DevAnyKR/CreMaker_TuneUp/README.md

# CreMaker_TuneUp

크리메이커 3D 프린터 메탈 V2에 관련된 튜닝 자료 공유 및 관리를 위한 공간입니다.

3D 모델은 '[3D_Models](/3D_Models)'에 분류별로 디렉토리가 구성되어 있습니다.

자세한 내용은 Wiki를 참고해주세요.
[Wiki 튜닝된 항목](../../wiki/튜닝된-항목)

***

### DevAny® 소개

자동화 기계를 제조, 납품, 기술 지원을 한 경험이 많으며, 정밀 기계 설계, 제작에 관심이 많은 기술 전문가입니다.

3D 출력용 PLA 재질로는 1/100mm 만큼의 기계 가공 공차를 따라갈 수는 없지만, 그에 걸맞는 기본 기계 원리만 적용하여도 최대한 교정을 할 수 있습니다. 튜닝 후, 실제 출력물 또한 상당히 매끄럽게 출력됩니다.

고급 부품을 사용하여 튜닝하면 더더욱 좋겠지만, DIY 프린터를 선택한 이유처럼 최대한 저렴한 비용으로 누구나 튜닝할 수 있도록 기술 자료를 등록합니다.

***

## 튜닝 미리보기

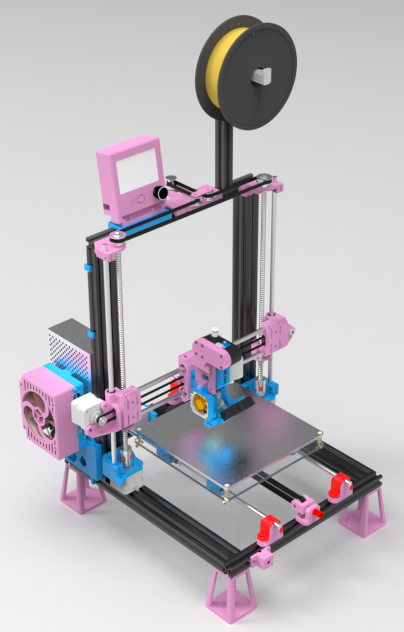
[picture p1: 3D_Models/CMV2_Tuned.png]


***

## Wiki

https://github.com/DevelopmentAnything/CreMaker_TuneUp/wiki

(정리된 문서입니다.)

## 토론
https://github.com/DevelopmentAnything/CreMaker_TuneUp/discussions

(의견, 질문을 할 수 있어요.)

## 보고
https://github.com/DevelopmentAnything/CreMaker_TuneUp/issues

(문제점, 버그 리포트를 해주세요.)

***

# License
파일별로 라이선스는 조금씩 다릅니다.
예) Cremaker의 파일, DevAny®의 파일

복잡할 것 없이, 자유롭게 사용하고, 개선된 내용은 피드백을 해주시면 됩니다.
(협업 목적)

복제 배포시 최초 원본 파일의 링크와 함께 배포를 권장합니다. (혼란 방지 및 피드백 목적)

코드를 변경 후 배포시 원본 파일 또는 원본 파일의 링크와 함께 수정된 파일의 코드도 배포해야 합니다.
예) STEP 파일을 변경하고 STL 파일로 변환된 파일을 배포 시, 변경된 STEP 파일도 함께 배포해야 합니다. (배포 받은 사용자도 원본을 수정할 권한이 있음)
