DevAnyKR/CreMaker_TuneUp/3D_Models/Addons/Acrylic_Reinforcement_Block/readme.md

# Acrylic_Reinforcement_Block



## 파일 설명

아크릴 휨 방지 강화 블록입니다.

## 출력 조건

- ~180mm_B1.stl 모델은 2개씩 1세트 출력. (측면 강화시 2세트 추가 출력)
  - 단, 손잡이 사용시 블록 1개를 ~180mm_B2.stl 모델로 대체합니다.
- ~100mm_B1.stl 모델은 2개씩 1세트 출력
- 구멍은 축소하면 뻑뻑해짐. 0.05~0.1 정도 확장 추천
- 넓은 면이 바닥으로 오도록 회전
- 재질: eSUN PLA+, PETG 이상의 강도를 가진 필라멘트 필수(절대 다락방 Fine PLA 사용 금지). 출력물이 휘면 안 됨.
- 내외벽 두께: 1.2mm 이상, 내부채움 지그재그 기준 50% 이상.



## 준비물

- M3\*20 볼트 및 너트 18개

***

# Bed Handle

## 파일 설명

아크릴 휨 방지 고정 블록에 사용하는 손잡이 입니다.



## 준비물

- M3\*12~15 볼트 및 너트 2개

## Update
-
