DevAnyKR/CreMaker_TuneUp/3D_Models/Addons/Gyro-Adapter/readme.md

# Gyro-Adapter

+ 자이로 스피너용 어댑터입니다.
+ 장식물입니다.

# 준비물

+ [Gyro Model](https://www.thingiverse.com/thing:2839576)
