DevAnyKR/CreMaker_TuneUp/3D_Models/Addons/Filament_Support/Bearing/ReadMe.md

# Bearing for Filament bobin

필라멘트 공급을 원활하게 하여 익스트루더 모터 부하를 줄이고 출력 품질을 일정하게 유지시킵니다.

## 미리 보기



## 출력 조건
- 눕혀서 출력
- 서포트 OFF

## 사용

1. 설명: 필라멘트 거치대에 끼워서 사용합니다.

2. 출력 개수: 4개 권장

※ 필라멘트 롤이 이탈되는 것을 방지하기 위해 아래 클립을 출력하여 끼워 줍니다.

https://github.com/simulz/CreMaker_TuneUp/tree/main/3D_Models/Addons/Filament_Support/Clip/STL
