DevAnyKR/CreMaker_TuneUp/3D_Models/Addons/Filament_Support/Clip/readme.md

# Clip for Bearing

필라멘트 보빈용 베어링 사용 시, 필라멘트 롤이 이탈되는 것을 방지하는 클립입니다.

## 사용 예





필라멘트를 거치하거나 제거할 때, 롤을 들어 올리면 되므로 사용하는데 불편이 없습니다.
