DevAnyKR/CreMaker_TuneUp/3D_Models/readme.md

# 디렉터리 구분
## Main Parts
프린터 주요 부품입니다.

## Addons
추가 액세서리입니다.

***

아래 그림 처럼 튜닝할 수 있습니다.



***

# Ultimaker Cura

오픈소스 무료 슬라이서

https://github.com/Ultimaker/Cura
