DevAnyKR/CreMaker_TuneUp/3D_Models/Addons/BTT_Smartsensor_Mount/readme.md

# BTT_Smartsensor_Mount



## 파일 설명

필라멘트 감지 센서용 마운트입니다.

### 효과

펄스 방식 센서는 필라멘트를 다 썼거나, 필라멘트가 내부에서 끊어졌거나, 노즐이 막혔거나, 기어가 헛돌거나, 필라멘트가 갈렸을 때 감지하여 출력을 일시정지합니다.

(On/Off 방식은 필라멘트가 없을 때만 감지하지만, BTT 센서는 흐름을 감지하여 위 상황을 모두 감지합니다.)

## 미리보기



## 출력 조건
- 서포트가 필요 없는 면이 바닥으로 오도록 회전

## 준비물

- M3\*40 볼트 및 너트 1개
- BTT Smart Filament Sensor
  - 구매링크: [AliExpress BigTreeTech 공식 스토어](https://s.click.aliexpress.com/e/_DeteAfP)



## 설치 및 사용





디스플레이 보드에 있는 커넥터에 꽂으면 됩니다.

터치 패널로 기기 설정으로 들어간 다음, 필라멘트 센서를 Auto로 설정하면 됩니다.



필라멘트를 삽입할 때 익스트루더 블록 구멍에 잘 들어가지 않으면, 센서 마운트 블록을 꺾어서 삽입하면 됩니다.

## Update
-
