DevAnyKR/CreMaker_TuneUp/3D_Models/Addons/Foot_Lift/readme.md

# Foot Lift

- 프린터를 올려주는 받침대 입니다.
- 바닥 공간이 생기므로 청소하기가 편합니다.

## 미리 보기



## 사용 예



## 출력 조건

+ 내부채움: 100%
+ 재질: eSun PLA+ 이상의 강도를 가진 필라멘트 권장
