DevAnyKR/CreMaker_TuneUp/3D_Models/Addons/Profile-Home-Cover/readme.md

# Profile-Home-Cover

프로파일의 홈을 덮는 커버입니다.

## 사용 예
