DevAnyKR/CreMaker_TuneUp/3D_Models/Addons/Tool_Holder/readme.md

# Tool-Holder

서포트가 필요 없는 공구 거치대입니다.

## 사용 예
