DevAnyKR/CreMaker_TuneUp/3D_Models/Addons/Z-Align-Indicator/readme.md

# Z-Align-Indicator

Z축의 원점이 정상적으로 원위치 됐는지 확인하는 표시기입니다.

## 사용 예



## 출력 조건

스크류에 꽂는 부품은 출력 설정에 따라 헛도는 경우가 있으니, 고정이 잘 되지 않으면 내경을 줄여서 출력해보세요.
