DevAnyKR/CreMaker_TuneUp/3D_Models/Main_Parts/Y/Y-bearing-block/readme.md

# Y-bearing-block

+ Y 벨트 장력 조절 블록입니다.



## 효과

### before

- 장력 조정용 측면 볼트를 조이면, 블록 조정용 볼트의 나사산이 뭉개짐
- 장력 조정을 하려면 볼트 4개를 모두 풀고 다시 조여야 함
- 장력 조정용 측면 볼트를 강하게 조이면, 너트 고정 부분이 파손됨

### after

- 볼트의 나사산이 뭉개지지 않음
- 주 블록은 알루미늄 프로파일에 한 번만 고정하면 되며, 장력 조정은 측면 볼트 1개만 풀고 조이면 됨
- 측면 솔리드는 보강대로 강하게 붙어있으므로 장력 조정 볼트를 강하게 조여도 파손 위험이 적음 

## 미리 보기

img (3)
img (4)

## 사용 예



## 파일 설명

+ 3.2L: 기본 모델(추천)
+ 3.3L: 측면 홈따기 모델(벨트가 기계의 중심이 아닐 때, 좌우 위치 조정용)

## 준비물

+ M6\*20~30mm 볼트
  + 볼트가 길 경우, washer 모델을 출력해서 사용하거나, 금형 스프링(내경 6mm)을 사용할 수 있습니다.

## 출력 조건

+ eSUN PLA+ 추천. 또는 PETG, ABS 등 강도가 높은 재질
+ 내외벽 1.2mm 이상, 내부채움 50% 이상
+ 측면이 베드 바닥으로 향하도록 배치 (조립 방향으로 배치하면 층이 분리될 수 있음)
