DevAnyKR/CreMaker_TuneUp/3D_Models/Main_Parts/Bed/Bed-belt-block/readme.md

# Bed-belt-block
+ Y 벨트를 고정하는 블록입니다.
+ 2차 저작물입니다, 원본: https://cafe.naver.com/cremaker/16533

## 효과

### Before

+ 진동 발생 및 블록이 헐거워지면 벨트가 빠짐

### After

+ 볼트로 압착하므로 벨트가 빠지지 않음

## 미리 보기





## 출력 조건

+ 재질: PLA 외.
+ 내외벽 두께는 0.8mm 이상, 내부채움은 지그재그 기준 20% 이상.
