DevAnyKR/CreMaker_TuneUp/3D_Models/Main_Parts/X/Self-Aligning-Module/readme.md

# Self-Aligning-Module

- Z축 상하 이동시, 리드스크류 진동을 흡수합니다.
- 자석을 사용함으로써 볼의 위아래 홈을 정렬하여 볼이 움직일 수 있도록 공간을 확보합니다.
- X축 어셈블리는 중력에 의해 얹혀있는 형태입니다.

selfaligningmodule

모듈 아래쪽 리드 스크류 블록만 떠는 것이 보이쥬?

## 효과

### before
- 스크류가 진동하는 것에 맞춰 X축 어셈블리가 XY 방향으로 진동함. 결국 Side wall의 Skin이 물결처럼 울퉁불퉁하게 출력 됩니다.
- 휘어진 스크류의 횡력이 베어링봉에 영향을 줍니다.

### After
- 꿀결~
- 자기정렬 모듈의 하부만 스크류에 맞춰 진동을 하며, 상부와 나머지 기계 부품에는 힘을 전달하지 않습니다.
- X축 어셈블리는 볼트 고정이 아니므로 손으로 들어올릴 수 있습니다.
- Z축이 하강 중, 한계를 넘어가거나 출력물에 부딪힐 경우 X축 어셈블리 전체가 들리므로 기계적인 손상을 줄입니다.
- (옵션)각 모듈마다 롱볼트 2개를 추가하여, X축 어셈블리가 분리되는 것을 강제할 수 있습니다(비추).

## 사용예




## 출력 조건

- *Magnet_Bottom Plate.stl*, *Magnet_Top Plate.stl* 모델은 1개씩 2세트 출력
- 서포트 필요 없는 방향으로 회전
- 개조된 *X-block-Cut* 모델을 사용해야 함.

### X-block 변경 사항

+ 상하 반전
+ self-aligning module 장착 홀
+ X축 베어링봉 고정 클립 반전
+ X축 베어링봉 길이 확장 가능
+ 모듈 간섭 부분 솔리드 잘라내기

## 추가 자재
+ 1세트: 6mm BB탄 4개, 상하 2극 분할 착자된 Ø8\*4mm 원형 자석 4개, M3\*8 2개, M3\*10 2개

  ※ 상하 2극 분할 자석이 아닌 수평 2극 분할 자석인 경우, 먼저 한 쪽의 자석을 본딩하고, 맞붙는 쪽의 자석은 가조립 상태에서 방향을 맞춘 후 본딩해야 합니다.(반발력으로 인한 오동작 방지)

## 조립



- 자석은 *록타이트 401* 접착제(혐기성 본드)로 고정합니다.

## Update
-
