DevAnyKR/CreMaker_TuneUp/3D_Models/Main_Parts/Y/Y-rod-support-Cover/ReadMe.md

# Y-rod-support-Cover

+ 심각한 설계 결함인 베어링봉 고정부를 개선한 모델입니다.

## 효과

### Before

+ 케이블 타이로는 베어링봉을 단단히 고정할 수 없음(디지털 조임 방식이므로)
+ 베드에 하중이 걸리면 베어링봉이 휘어짐. 이동 부하 발생 및 출력물 높이 변형 문제 발생

### After

+ 강력한 힘으로 베어링봉을 고정할 수 있음
+ 베드에 하중이 걸려도 베어링봉을 수평 상태로 유지함
+ 미관이 좋아짐

## 파일 설명
- Y-rod-support-Cover_A.stl

*단순 돔 모양의 기본형 (순정 블록용)*

- Y-rod-support-Cover_B.stl

*LM8LUU용 간섭 제거 (롱타입 부싱 블록용)*

# 출력 조건



+ 그림과 같이 볼트 구멍 방향을 참고하여 모델을 눕혀서 배치.
+ 힘이 작용하므로 eSun PLA+, PETG 같은 고강도 재질 필수(다락방 PLA Fine 절대 비추).
+ 효과를 극대화 하려면 관통형 모델을 사용하고, Y축 베어링봉을 최소 410mm 이상으로 교체할 것.

***
## Update
1.2, 2.2: 바닥 안쪽 모따기 치수 변경 0.5→1.0
