DevAnyKR/CreMaker_TuneUp/3D_Models/Main_Parts/Z/BearingUnit-Bottom/readme.md

# BearingUnit-Bottom

- 리드 스크류를 베어링으로 동심을 잡아주는 블록입니다.

# 안내

- 이 모델은 폐기되었습니다.
- [Screw-Coupler](https://github.com/simulz/CreMaker_TuneUp/tree/main/3D_Models/Main_Parts/Z/Screw-Coupler) 와 [Self-Aligning-Module](https://github.com/simulz/CreMaker_TuneUp/tree/main/3D_Models/Main_Parts/X/Self-Aligning-Module)을 사용하세요.
