DevAnyKR/CreMaker_TuneUp/3D_Models/Main_Parts/Z/Screw-Coupler/readme.md

# Screw-Coupler

- 이 튜닝은 출력물이 아닌 기성품을 교체하는 것입니다.

## 효과

### before

- 스크류의 나사산이 뭉개짐
- 커플러가 압축·인장 되면서 높이가 변하여 X축의 수평이 틀어짐
- 커플러와 스크류의 동심이 맞지 않아 회전시 XY 방향으로 진동 발생
- 커플러의 내경이 커서 스크류를 수직으로 고정할 수 없음

### after
- 스크류의 나사산 전체를 감싸는 방식으로 뭉개짐이 거의 없음
- 우레탄을 사용하여 커플러의 높이가 변하지 않음
- 스크류를 감싸는 방식으로 고정되므로 동심이 거의 맞음
- 커플러가 휘지 않으므로 스크류를 수직으로 고정할 수 있음

## 사용예



## 준비물



- 지름 20mm, 길이 25mm, 내경은 위아래가 각각 5mm, 8mm의 커플러 2개

AliExpress:

https://s.click.aliexpress.com/e/_De5ohud

https://s.click.aliexpress.com/e/_DEQ3OeH

***
## Update

-
