DevAnyKR/CreMaker_TuneUp/3D_Models/Main_Parts/Power_Board/Board-Case-Cover_92mm-Fan/readme.md

# Board Case Cover for 92m Fan

메인보드 여닫이 커버입니다.

로고를 넣었지만 점은 없는 짝퉁 로고... 시원하게 뚫어버렸습니다.

원본: https://cafe.naver.com/cremaker/16533

## 미리보기

img1 daumcdn

## 사용예




## 추천


온도 스위치를 연결하여 모터 드라이버가 뜨거워질 때만 팬이 회전하도록 하는 방법으로, 뜨거워지는 상태를 알 수 있으며, 불필요한 동작을 방지할 수 있습니다.

## 준비물

팬: NOCTUA NF-A9x14 PWM 

DCDC컨버터: SZH-PWSD-014

## 추가 준비물

온도 스위치: PT-01 50~70℃

써멀 패드: 15W/mk 권장

## 출력 조건

재질: 상관 없음

방향: 넓은 면이 바닥으로 오도록 배치
