DevAnyKR/CreMaker_TuneUp/3D_Models/Main_Parts/Z/BearingUnit-Top/readme.md

# BearingUnit-Top

- 리드 스크류를 베어링 유닛으로 동심을 잡아주는 블록입니다.
- [Self-Aligning-Module](https://github.com/simulz/CreMaker_TuneUp/tree/main/3D_Models/Main_Parts/X/Self-Aligning-Module)을 적용했다면 베어링 유닛을 장착할 필요가 없습니다.

## 미리보기



## 출력하기

+ 원본 모델 1개, 반전된 모델 1개

+ 윗면을 베드면에 붙여서 서포트가 필요 없도록 배치

## 준비물

+ KFL08 베어링 유닛 2개

+ M4*10 볼트, 너트 2개씩 2세트

## Update

+ 2022.05.29  모따기 복구
