DevAnyKR/CreMaker_TuneUp/3D_Models/Main_Parts/Z/Z-Sync-Pully/readme.md

# Z-Sync-Pully



- Z축 리드 스크류를 동기화 해주는 모듈입니다.

## 효과

### before

- 두 개의 Z축 중 한 쪽만 회전했을 때, X축 수평이 틀어짐.
  - 스텝 모터 제어는 마이크로스텝 단위이기 때문에, 전원이 ON/OFF 될 때마다, 가장 가까운 극으로 로터가 회전함. 이 때 양쪽 스텝모터의 각도가 차이날 수 있음. 사용할 수록 오차가 누적이 됨.
  - 어떠한 부하로 인해 어느 한 쪽의 Z축이 틀어졌을 때.
  - 스프링형 커플러의 인장·압축 현상으로 인해 어느 한 쪽의 Z축이 틀어졌을 때.

### after
- 두 개의 Z축은 항시 같은 각도로 회전하므로, X축 수평이 틀어지지 않음. 오차가 누적 되지 않음.

## 사용예





## 준비물

- 20~40tooth GT2 타이밍 풀리 2개
- GT2 베어링 풀리 3개
- 680~864mm 루프형 GT2 타이밍 벨트
  - 762mm 이하용 블록은 디자인 필요. 요청시 올립니다.
- M5\*25 볼트 3개
- M4\*20 볼트 1개

***
## Update

-
