DevAnyKR/CreMaker_TuneUp/3D_Models/Main_Parts/Bed/Support/readme.md

# Bed-Support

- 이 튜닝은 출력물이 아닌 기성품을 교체하는 것입니다.

## 효과

### before

img (2)

- 3점이 아닌 4점 레벨 방식은 평면이 뒤틀릴 수 밖에 없음
- 스프링 때문에 나비 너트가 고정되지 않으므로, 사용 중 충격에 의해 너트가 조금씩 풀려서 베드가 뒤틀어짐
- 틀어지거나 안착 불량일 때마다 베드 레벨을 조정해야 함

### after
- 베드가 일정한 높이로 고정되어 있으므로 뒤틀림이 거의 없음 (그래도 뒤틀린다면 이는 Y축이 문제이므로 이 프로젝트의 Y축 튜닝을 참고)
- 볼트로 완전 체결이 되어 베드의 귀퉁이 높이가 변하지 않음
- 오랜 시간을 사용해도 베드 레벨이 유지되어 텐션 조정이 필요 없음 (실제로 수 년동안 베드 조정 없이 사용함)

## 사용예



## 준비물

- 높이 15mm의 황동 서포트 4개. 실측값을 모를 경우, 여러개를 구입 후 같은 높이만 골라내는 것을 권장.
- 평와셔 8개

***
## Update

-
