DevAnyKR/CreMaker_TuneUp/3D_Models/Main_Parts/Display/Angle_Adjustable_Case/readme.md

각도 조절 되는 디스플레이 커버입니다.

원본: https://cafe.naver.com/cremaker/16533

***

## 미리보기




## 사용예




## 준비물

볼트: 육각소켓머리 M3, M4

## 출력 조건

재질: eSun PLA+ 이상의 강도를 가진 필라멘트 사용 권장
