DevAnyKR/CreMaker_TuneUp/3D_Models/Addons/BTT_Smartsensor_Mount/STL/BTTSensorMount_forMaincover V2.0.stl

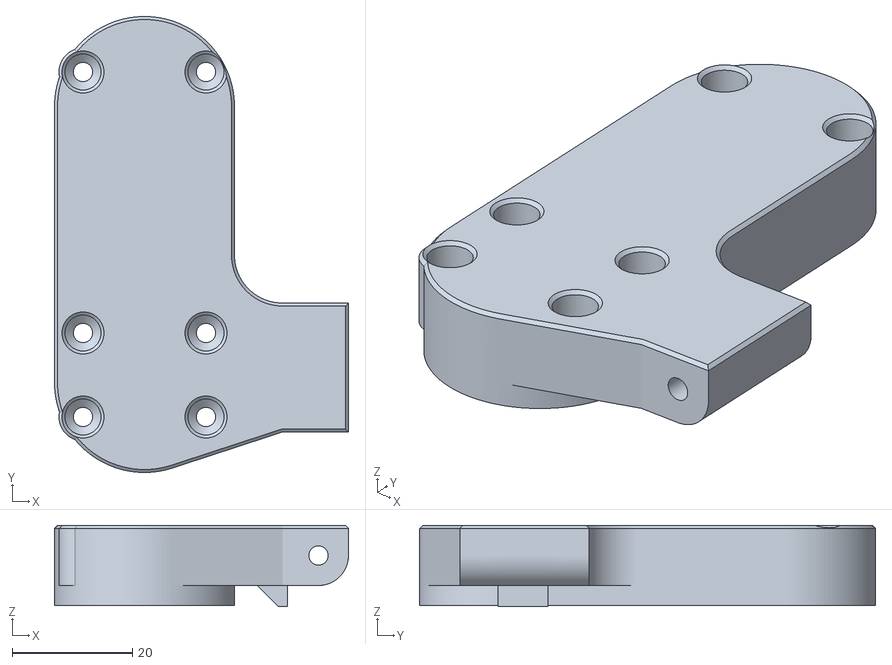
[picture p2: CAD file, 2022-05-19]
3D_Models/Addons/BTT_Smartsensor_Mount/STL/BTTSensorMount_forMaincover V2.0.stl
49.0 x 76.0 x 13.5
