DevAnyKR/CreMaker_TuneUp/3D_Models/Addons/Tool_Holder/STL/tool_holder_full_nonplate.stl

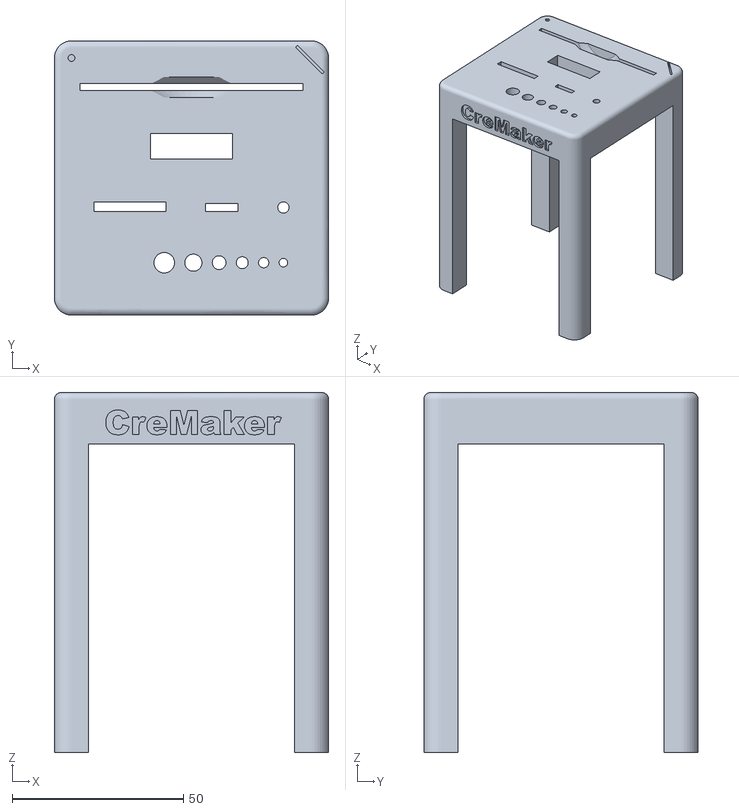
[picture p3: CAD file, 2022-05-19]
3D_Models/Addons/Tool_Holder/STL/tool_holder_full_nonplate.stl
80.0 x 80.0 x 105.0
