DevAnyKR/CreMaker_TuneUp/3D_Models/Addons/Acrylic_Reinforcement_Block/STL/Acrylic_Reinforcement_Block_180mm_B2.stl

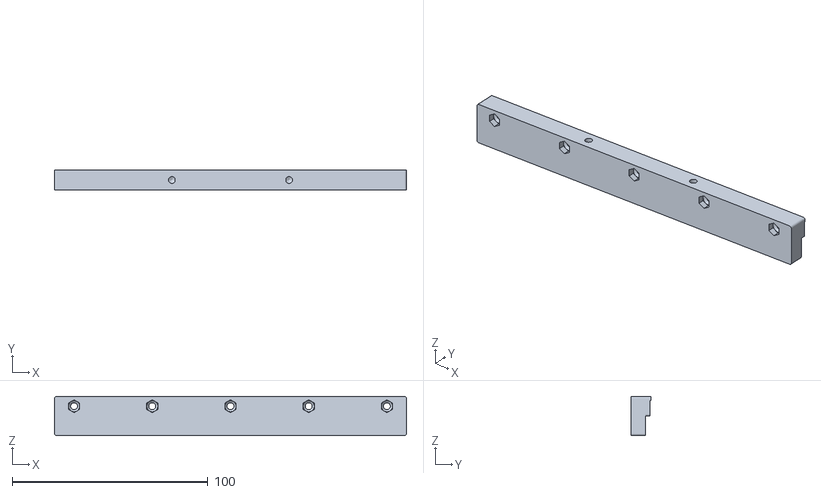
[picture p4: CAD file, 2022-05-25]
3D_Models/Addons/Acrylic_Reinforcement_Block/STL/Acrylic_Reinforcement_Block_180mm_B2.stl
180.0 x 10.0 x 20.0
