DevAnyKR/CreMaker_TuneUp/3D_Models/Addons/Filament_Support/Bearing/STL/Bearing O52_I27_T15.stl

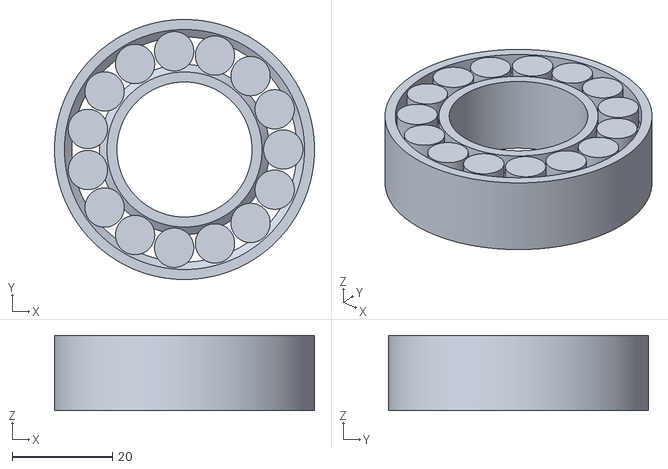
[picture p5: CAD file, 2022-05-19]
3D_Models/Addons/Filament_Support/Bearing/STL/Bearing O52_I27_T15.stl
52.0 x 52.0 x 15.0
