DevAnyKR/CreMaker_TuneUp/3D_Models/Addons/Filament_Support/Clip/STL/Clip6.stl

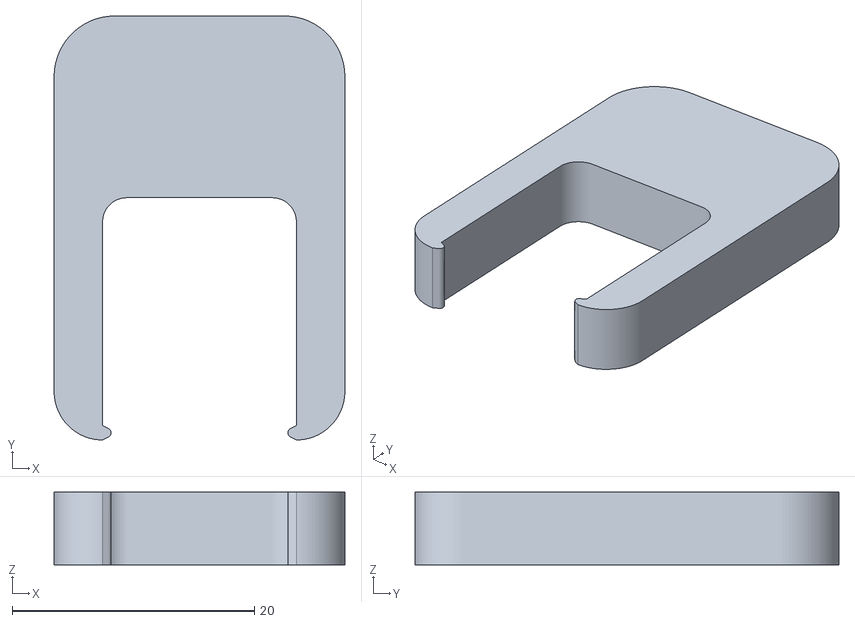
[picture p6: CAD file, 2022-05-19]
3D_Models/Addons/Filament_Support/Clip/STL/Clip6.stl
24.0 x 35.0 x 6.00
