DevAnyKR/CreMaker_TuneUp/3D_Models/Addons/Foot_Lift/STL/Foot Lift Left v1.stl

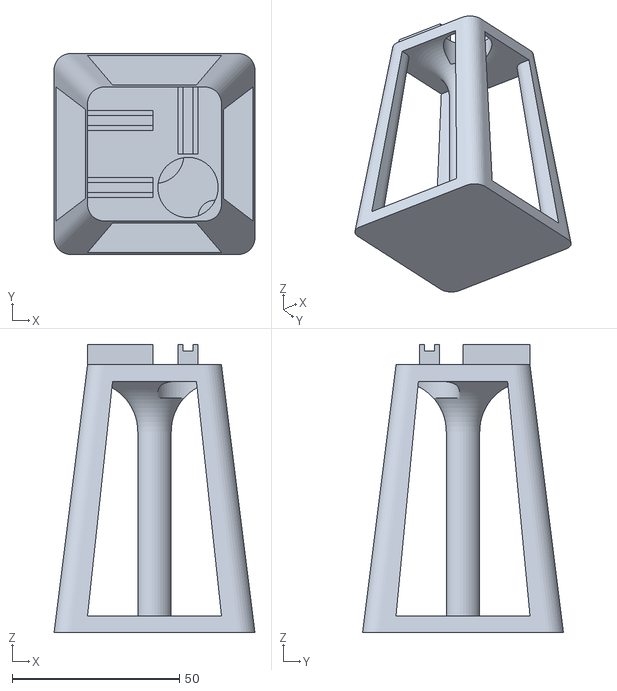
[picture p7: CAD file, 2022-05-20]
3D_Models/Addons/Foot_Lift/STL/Foot Lift Left v1.stl
60.0 x 60.0 x 86.0
