DevAnyKR/CreMaker_TuneUp/3D_Models/Addons/Gyro-Adapter/stl/X Motor cover.stl

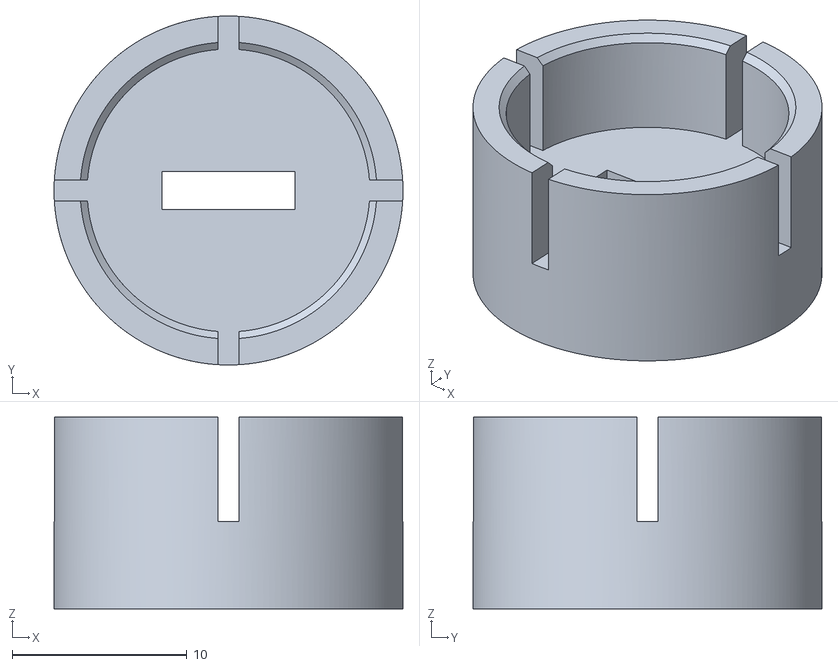
[picture p8: CAD file, 2022-06-06]
3D_Models/Addons/Gyro-Adapter/stl/X Motor cover.stl
20.0 x 20.0 x 11.0
