DevAnyKR/CreMaker_TuneUp/3D_Models/Addons/Profile-Home-Cover/Cover10mm.stl

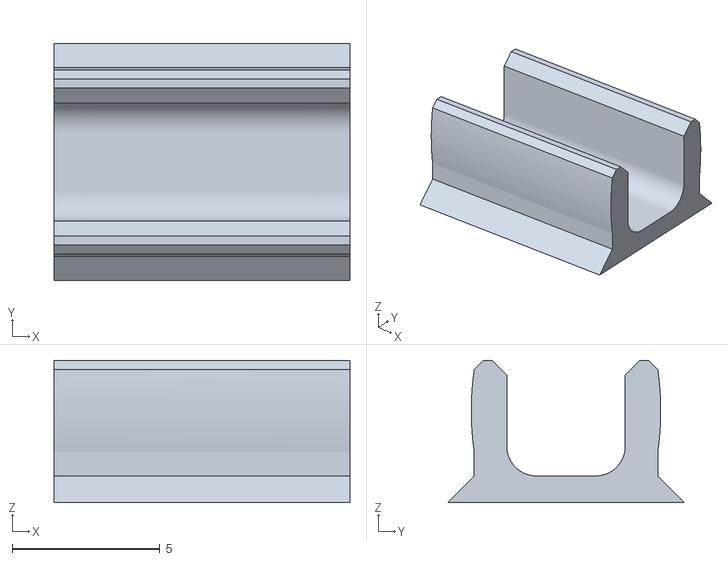
[picture p9: CAD file, 2022-06-06]
3D_Models/Addons/Profile-Home-Cover/Cover10mm.stl
10.0 x 8.00 x 4.80
