DevAnyKR/CreMaker_TuneUp/3D_Models/Addons/Tool_Holder/STL/tool_holder_bottomplate.stl

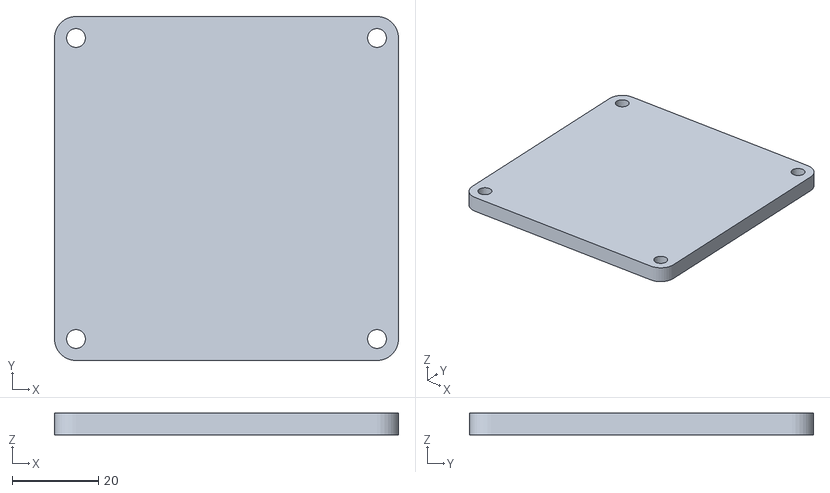
[picture p10: CAD file, 2022-05-19]
3D_Models/Addons/Tool_Holder/STL/tool_holder_bottomplate.stl
80.0 x 80.0 x 5.00
