DevAnyKR/CreMaker_TuneUp/3D_Models/Addons/Z-Align-Indicator/Z축 정렬 기준점.stl

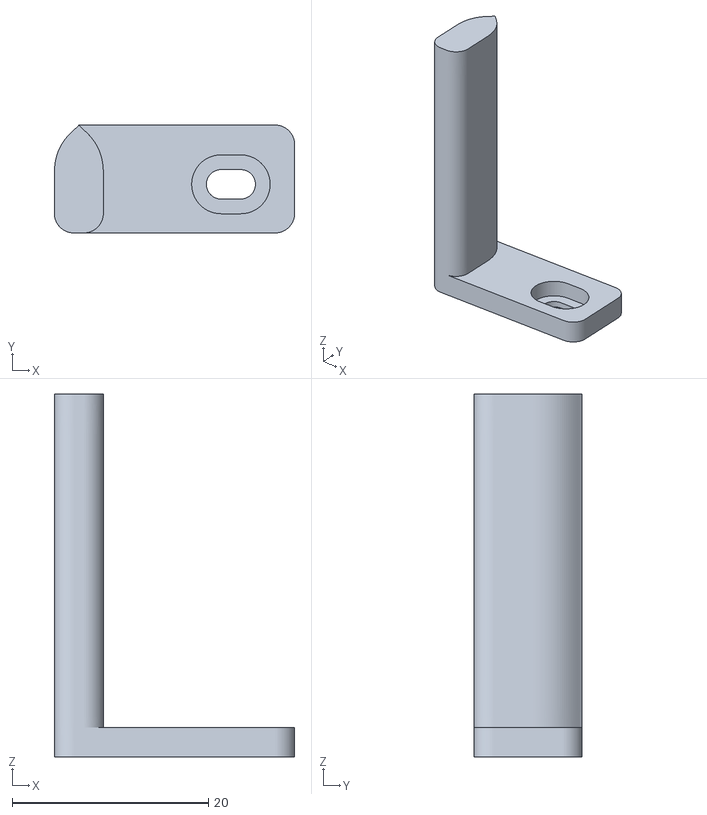
[picture p11: CAD file, 2022-06-06]
3D_Models/Addons/Z-Align-Indicator/Z축 정렬 기준점.stl
24.5 x 11.0 x 37.0
