DevAnyKR/CreMaker_TuneUp/3D_Models/Main_Parts/Bed/Bed-belt-block/STL/(2.05)bed-belt-block2.stl

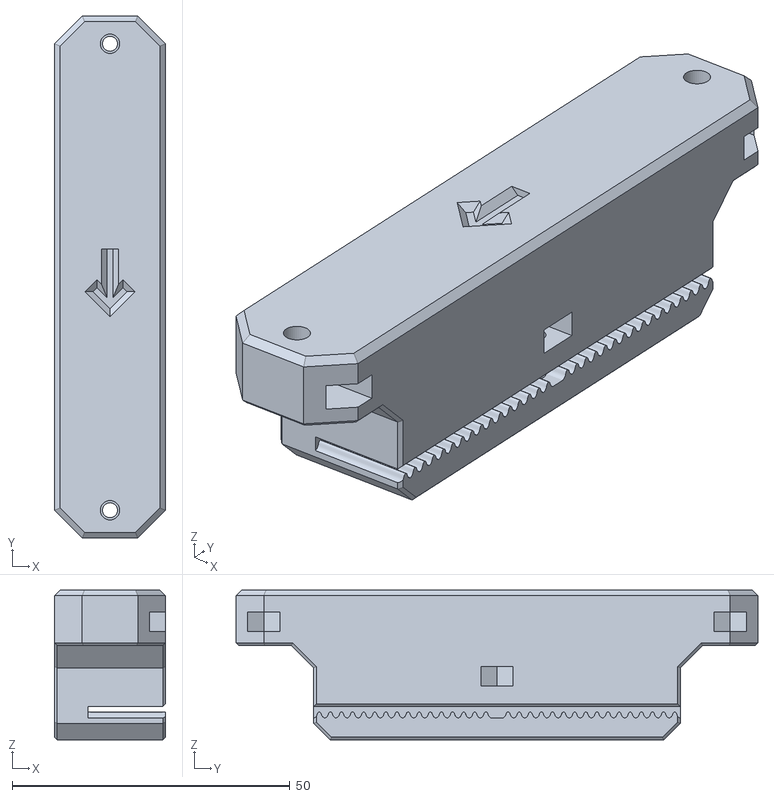
[picture p12: CAD file, 2023-05-15]
3D_Models/Main_Parts/Bed/Bed-belt-block/STL/(2.05)bed-belt-block2.stl
20.0 x 94.0 x 27.0
