DevAnyKR/CreMaker_TuneUp/3D_Models/Main_Parts/Display/Angle_Adjustable_Case/STL/Display_case_cover.stl

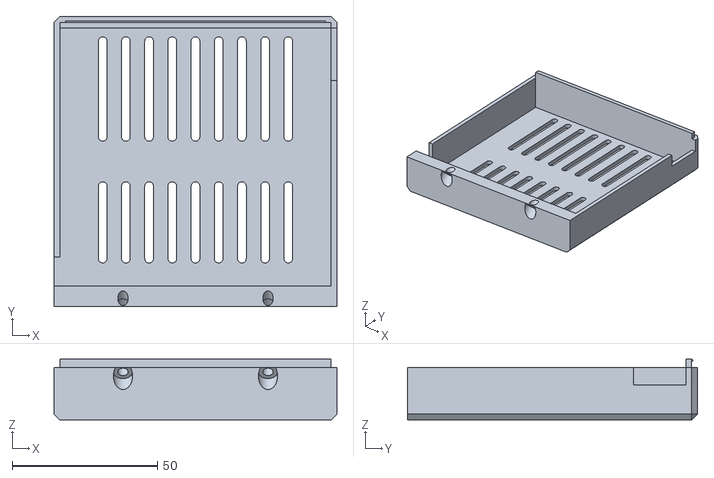
[picture p13: CAD file, 2022-05-19]
3D_Models/Main_Parts/Display/Angle_Adjustable_Case/STL/Display_case_cover.stl
97.5 x 100.0 x 21.0
