DevAnyKR/CreMaker_TuneUp/3D_Models/Main_Parts/Display/Angle_Adjustable_Case/stp/Display_case_front.step

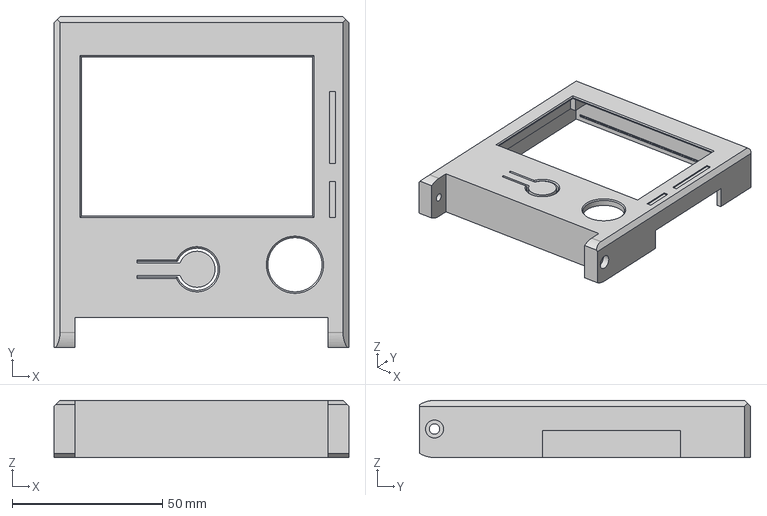
[picture p14: CAD file, 2022-05-23]
3D_Models/Main_Parts/Display/Angle_Adjustable_Case/stp/Display_case_front.step
98.0 x 110.0 x 19.0 mm
