DevAnyKR/CreMaker_TuneUp/3D_Models/Main_Parts/Power_Board/Board-Case-Cover_92mm-Fan/stp/Board-Case-Cover_Inner.step

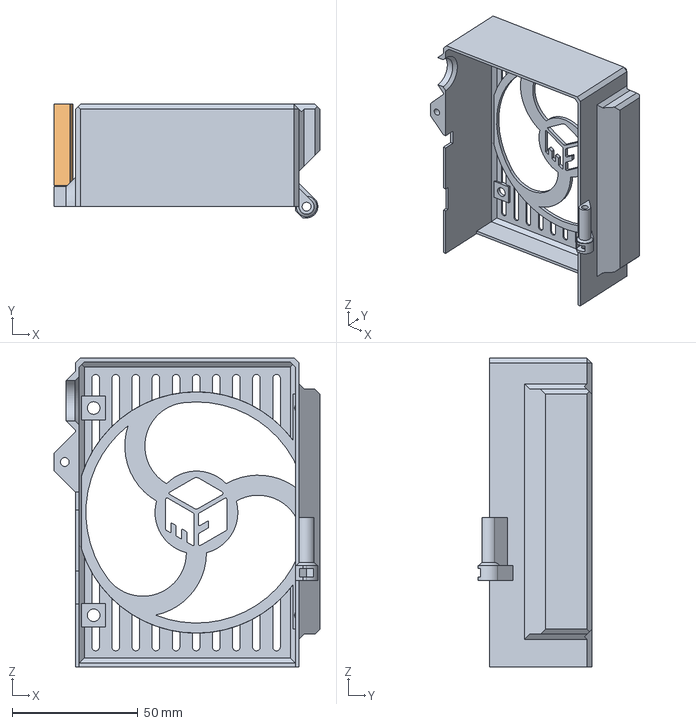
[picture p15: CAD file, 2022-05-21]
3D_Models/Main_Parts/Power_Board/Board-Case-Cover_92mm-Fan/stp/Board-Case-Cover_Inner.step
105.8 x 45.3 x 123.0 mm
