DevAnyKR/CreMaker_TuneUp/3D_Models/Main_Parts/X/Self-Aligning-Module/STL/Magnet_Top Plate.stl

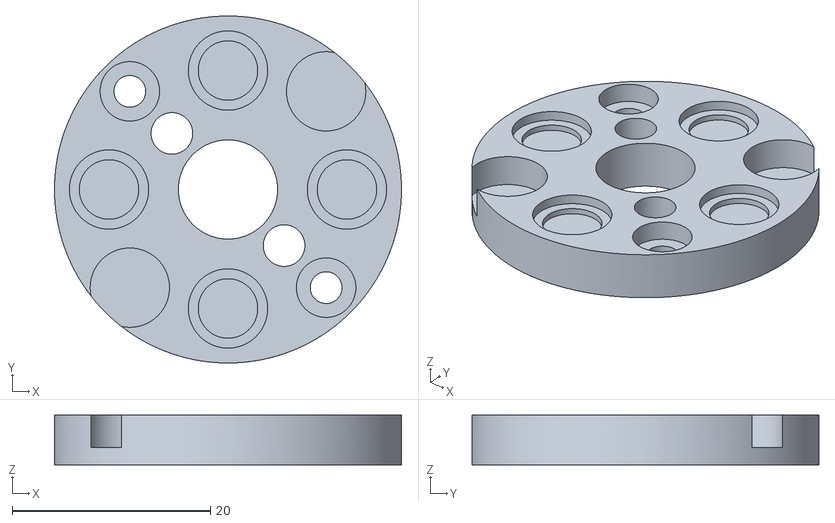
[picture p16: CAD file, 2022-05-19]
3D_Models/Main_Parts/X/Self-Aligning-Module/STL/Magnet_Top Plate.stl
35.0 x 35.0 x 5.00
