DevAnyKR/CreMaker_TuneUp/3D_Models/Main_Parts/X/Self-Aligning-Module/stp/X-block-R.stp

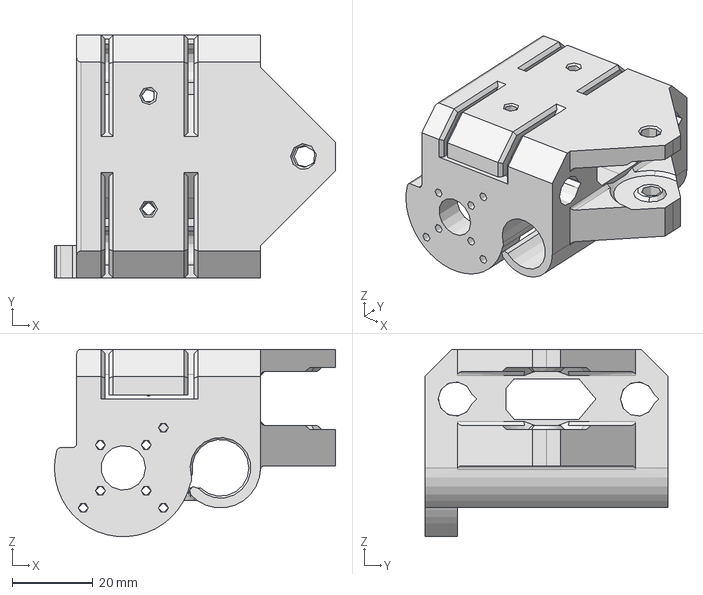
[picture p17: CAD file, 2022-05-29]
3D_Models/Main_Parts/X/Self-Aligning-Module/stp/X-block-R.stp
69.4 x 60.0 x 46.2 mm
