DevAnyKR/CreMaker_TuneUp/3D_Models/Main_Parts/Y/Y-rod-support-Cover/STP/Y-rod-support-Cover_A.stp

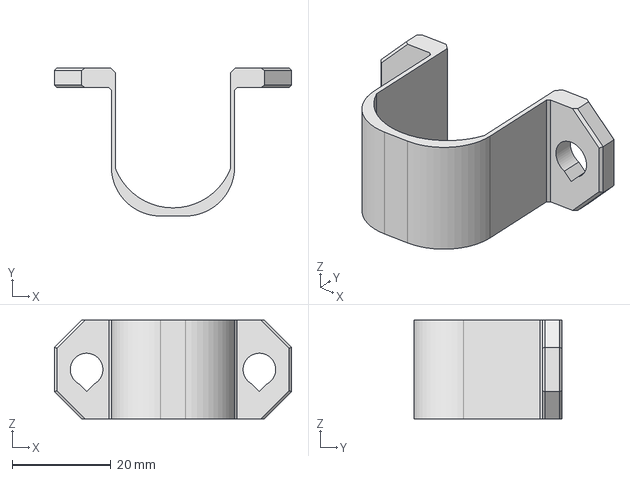
[picture p18: CAD file, 2022-05-20]
3D_Models/Main_Parts/Y/Y-rod-support-Cover/STP/Y-rod-support-Cover_A.stp
48.0 x 30.0 x 20.0 mm
