DevAnyKR/CreMaker_TuneUp/3D_Models/Main_Parts/Z/BearingUnit-Bottom/STL/BearingUnit-Bottom-L.stl

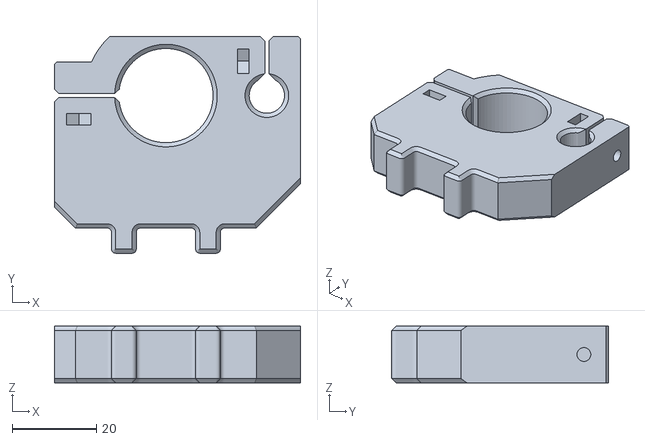
[picture p20: CAD file, 2022-05-19]
3D_Models/Main_Parts/Z/BearingUnit-Bottom/STL/BearingUnit-Bottom-L.stl
58.5 x 51.5 x 13.5
