DevAnyKR/CreMaker_TuneUp/3D_Models/Main_Parts/Z/BearingUnit-Top/stp/Top-cap-L.step

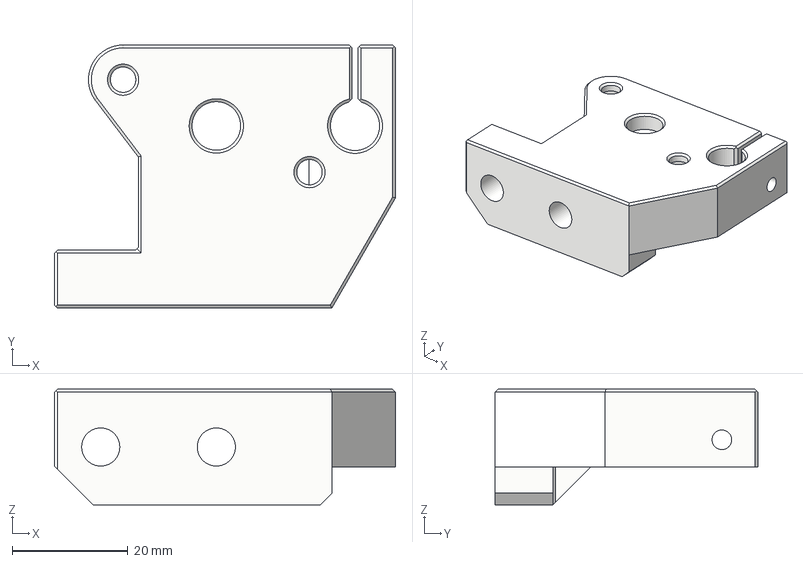
[picture p21: CAD file, 2022-05-29]
3D_Models/Main_Parts/Z/BearingUnit-Top/stp/Top-cap-L.step
59.0 x 45.5 x 20.0 mm
