DevAnyKR/CreMaker_TuneUp/3D_Models/Main_Parts/Z/Z-Sync-Pully/STL/Pully Lift.stl

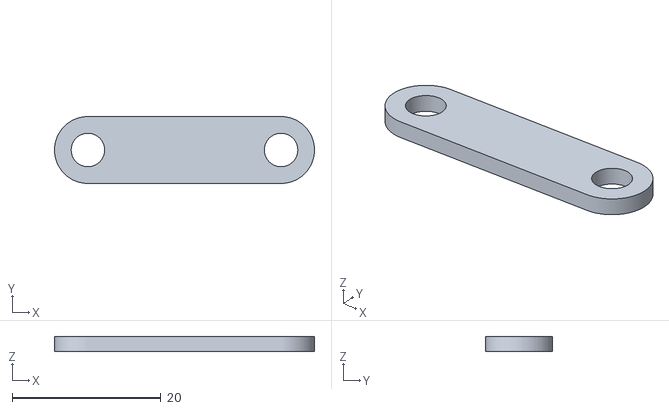
[picture p22: CAD file, 2022-05-19]
3D_Models/Main_Parts/Z/Z-Sync-Pully/STL/Pully Lift.stl
35.0 x 9.00 x 2.00
