DevAnyKR/CreMaker_TuneUp/3D_Models/Addons/Acrylic_Reinforcement_Block/STL/Acrylic_Reinforcement_Block_100mm_B1.stl

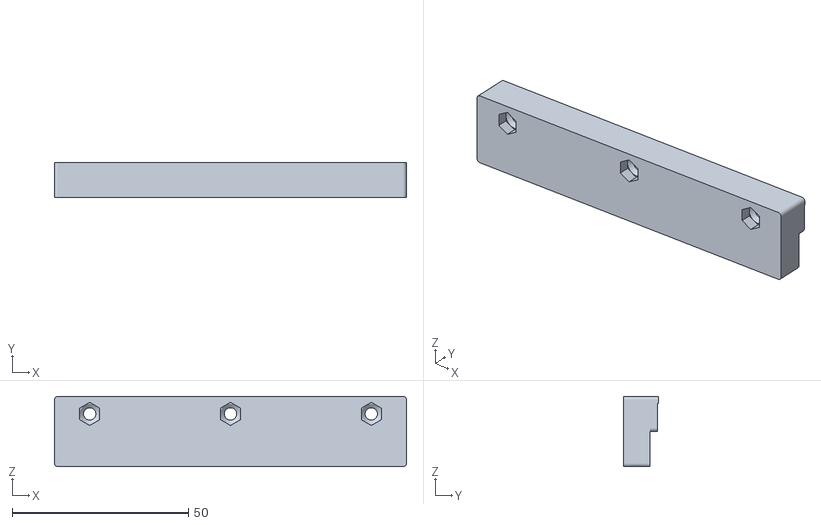
[picture p23: CAD file, 2022-05-25]
3D_Models/Addons/Acrylic_Reinforcement_Block/STL/Acrylic_Reinforcement_Block_100mm_B1.stl
100.0 x 10.00 x 20.0
