DevAnyKR/CreMaker_TuneUp/3D_Models/Addons/BTT_Smartsensor_Mount/STL/Body-cover V2.0.stl

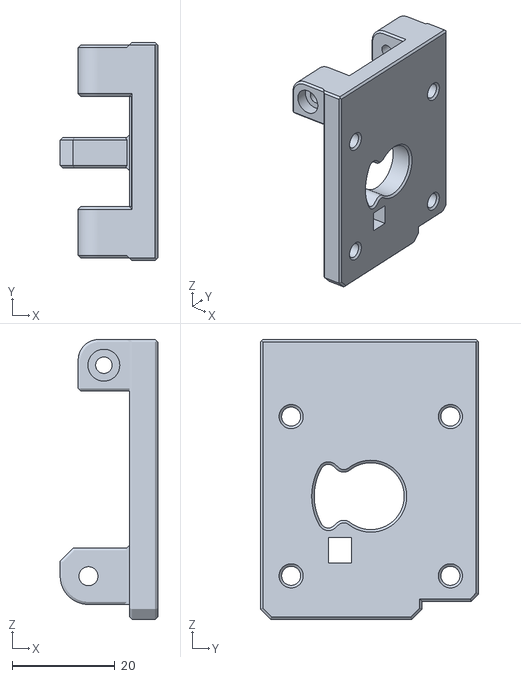
[picture p24: CAD file, 2022-05-19]
3D_Models/Addons/BTT_Smartsensor_Mount/STL/Body-cover V2.0.stl
19.0 x 42.5 x 54.5
