DevAnyKR/CreMaker_TuneUp/3D_Models/Addons/Z-Align-Indicator/Z축 정렬 표시기 I8.4.stl

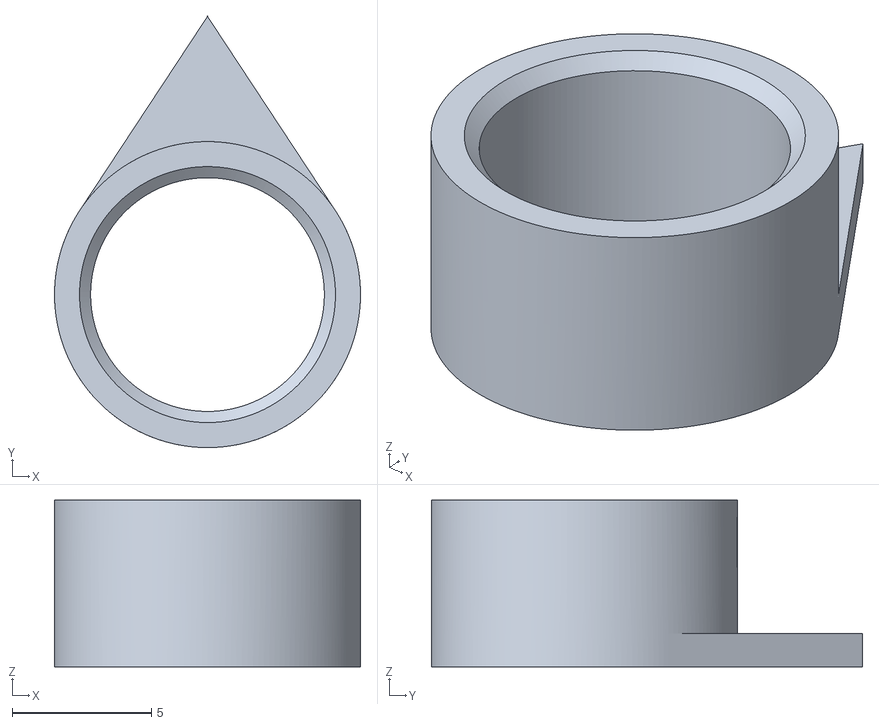
[picture p26: CAD file, 2022-06-06]
3D_Models/Addons/Z-Align-Indicator/Z축 정렬 표시기 I8.4.stl
11.0 x 15.5 x 6.00
