DevAnyKR/CreMaker_TuneUp/3D_Models/Main_Parts/Display/Angle_Adjustable_Case/STL/Display_case_bottom.stl

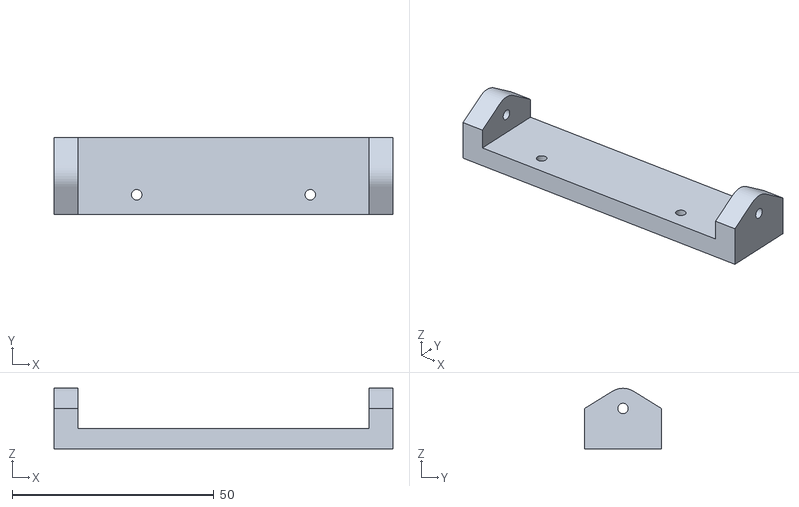
[picture p27: CAD file, 2022-05-19]
3D_Models/Main_Parts/Display/Angle_Adjustable_Case/STL/Display_case_bottom.stl
84.0 x 19.0 x 15.0
