DevAnyKR/CreMaker_TuneUp/3D_Models/Main_Parts/X/Self-Aligning-Module/stp/X-Carrige.stp

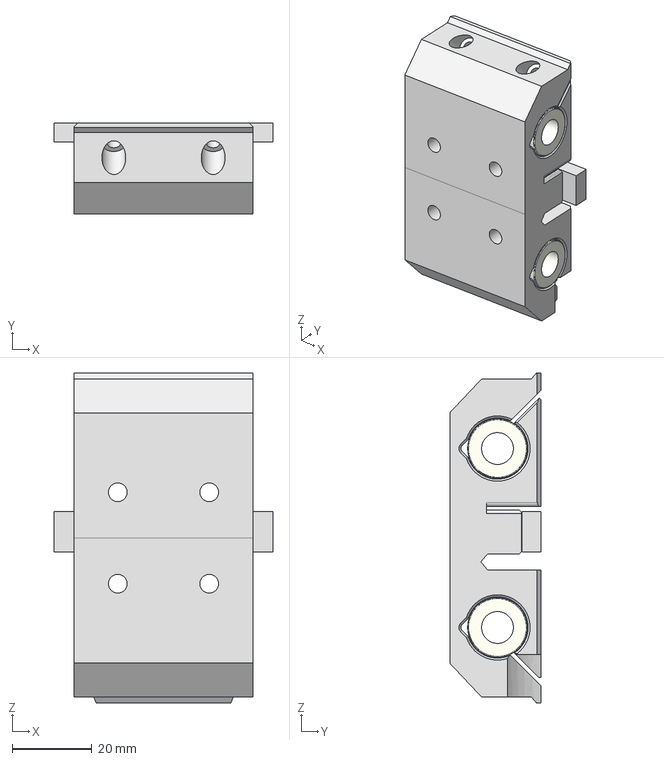
[picture p28: CAD file, 2022-05-29]
3D_Models/Main_Parts/X/Self-Aligning-Module/stp/X-Carrige.stp
55.0 x 23.0 x 83.0 mm
LM8LUU x 2
X-Carrige_1
