DevAnyKR/CreMaker_TuneUp/3D_Models/Main_Parts/Y/Y-bearing-block/STL/Y-bearing-block3.3-L.stl

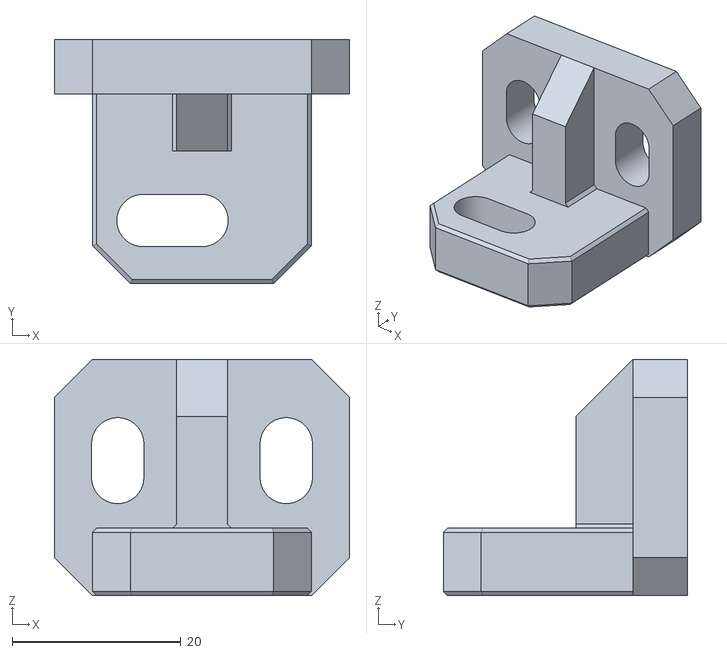
[picture p29: CAD file, 2022-05-19]
3D_Models/Main_Parts/Y/Y-bearing-block/STL/Y-bearing-block3.3-L.stl
35.0 x 29.0 x 28.0
