DevAnyKR/CreMaker_TuneUp/3D_Models/Main_Parts/Y/Y-rod-support-Cover/STP/Y-rod-support-Cover_B.stp

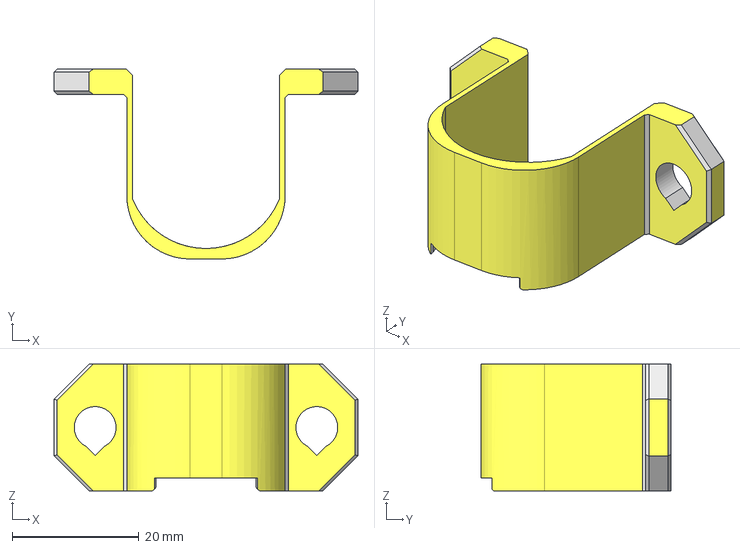
[picture p30: CAD file, 2022-05-20]
3D_Models/Main_Parts/Y/Y-rod-support-Cover/STP/Y-rod-support-Cover_B.stp
48.0 x 30.0 x 20.0 mm
