DevAnyKR/CreMaker_TuneUp/3D_Models/Main_Parts/Y/Y-rod-support/stp/Y-rod-support_B2.stp

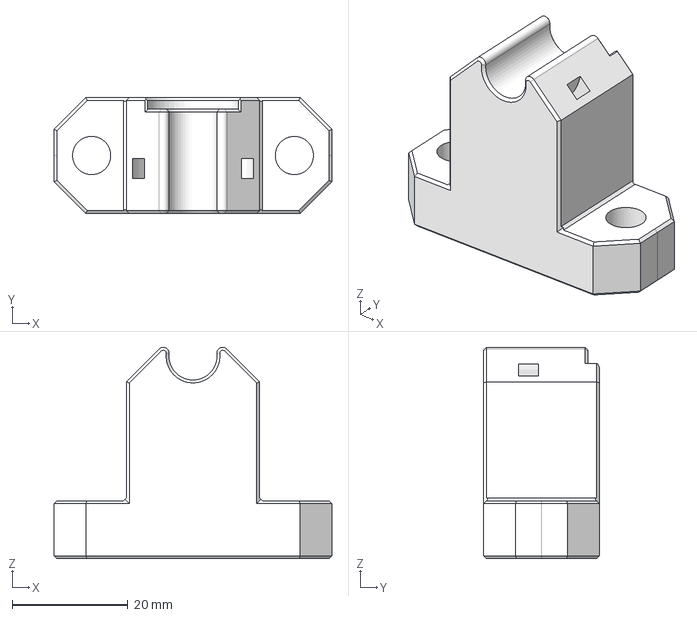
[picture p31: CAD file, 2022-05-21]
3D_Models/Main_Parts/Y/Y-rod-support/stp/Y-rod-support_B2.stp
48.0 x 20.0 x 36.5 mm
