DevAnyKR/CreMaker_TuneUp/3D_Models/Main_Parts/Z/Z-Sync-Pully/STL/Z-Sync-Pully_Guide.stl

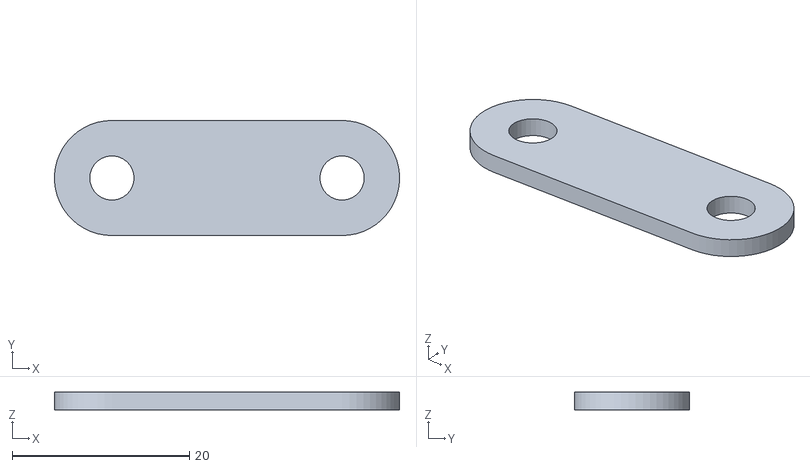
[picture p32: CAD file, 2022-05-19]
3D_Models/Main_Parts/Z/Z-Sync-Pully/STL/Z-Sync-Pully_Guide.stl
39.0 x 13.0 x 2.00
