DevAnyKR/CreMaker_TuneUp/3D_Models/Addons/Filament_Support/Clip/STL/Clip10.stl

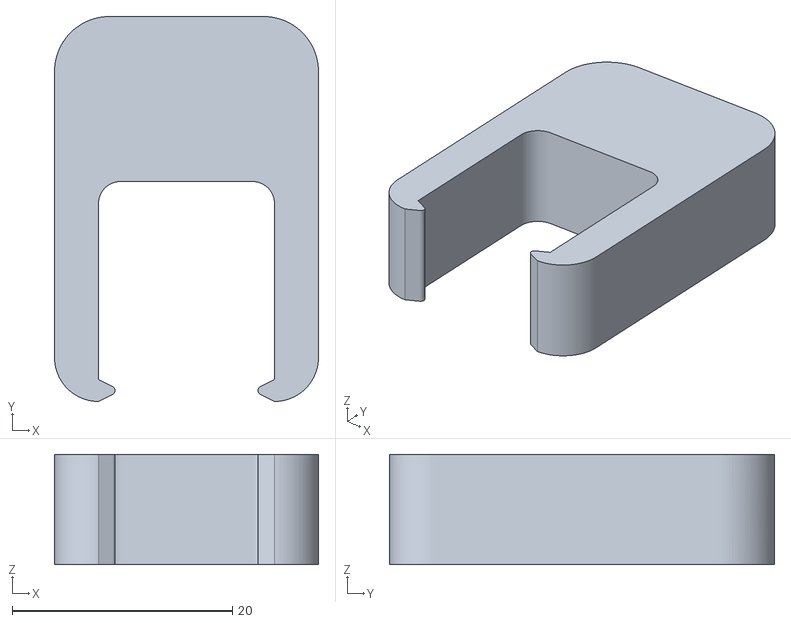
[picture p33: CAD file, 2022-05-19]
3D_Models/Addons/Filament_Support/Clip/STL/Clip10.stl
24.0 x 35.0 x 10.0
