DevAnyKR/CreMaker_TuneUp/3D_Models/Main_Parts/X/Self-Aligning-Module/STL/X-block-L_V2.1.stl

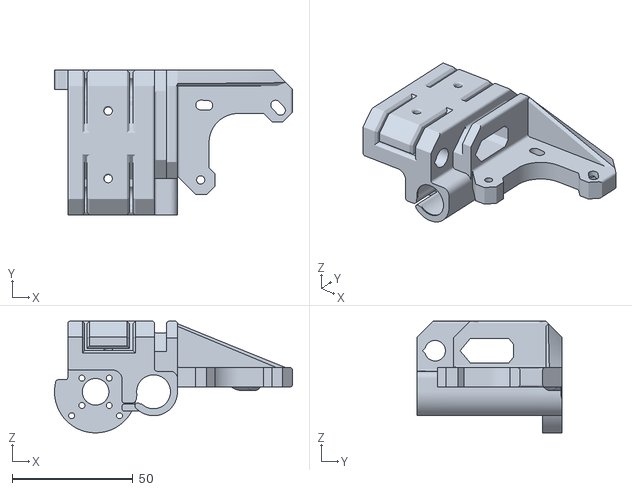
[picture p34: CAD file, 2022-05-19]
3D_Models/Main_Parts/X/Self-Aligning-Module/STL/X-block-L_V2.1.stl
98.5 x 60.0 x 46.2
