DevAnyKR/CreMaker_TuneUp/3D_Models/Main_Parts/Z/Z-Sync-Pully/STL/Z-Sync-Pully_Tensioner.stl

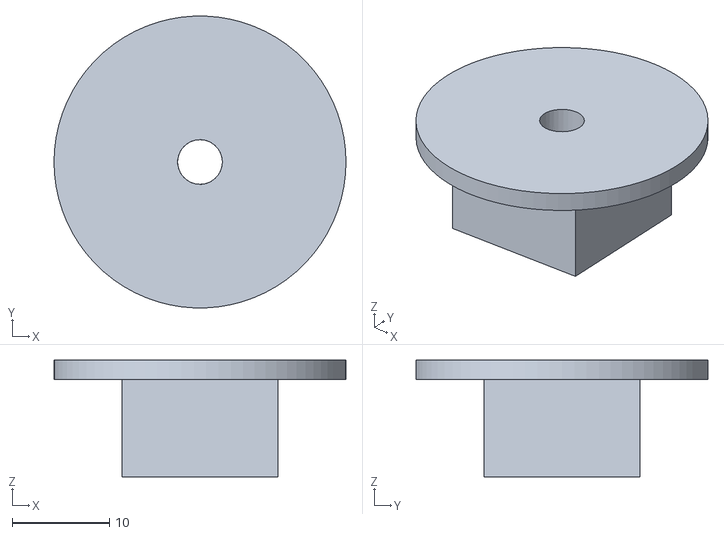
[picture p35: CAD file, 2022-05-19]
3D_Models/Main_Parts/Z/Z-Sync-Pully/STL/Z-Sync-Pully_Tensioner.stl
30.0 x 30.0 x 12.0
