DevAnyKR/CreMaker_TuneUp/3D_Models/Addons/Acrylic_Reinforcement_Block/STL/Bed_Handle_40mm_B1.stl

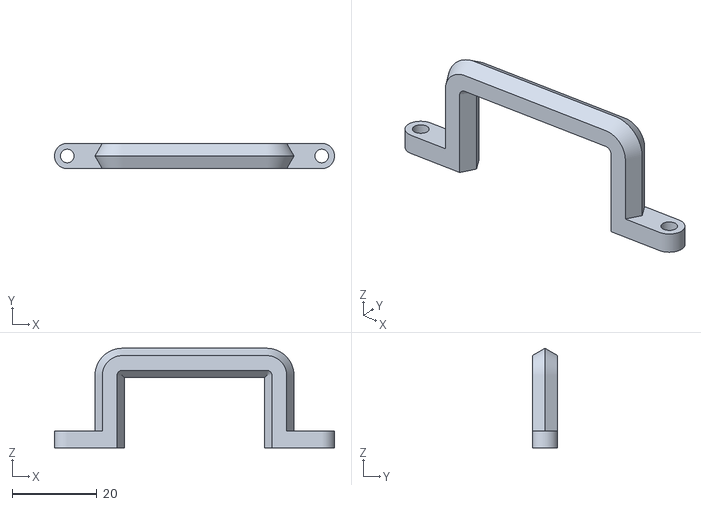
[picture p36: CAD file, 2022-05-19]
3D_Models/Addons/Acrylic_Reinforcement_Block/STL/Bed_Handle_40mm_B1.stl
66.0 x 6.00 x 23.5
