DevAnyKR/CreMaker_TuneUp/3D_Models/Main_Parts/Z/Z-Sync-Pully/STL/Z-Sync-Pully_T-Block.stl

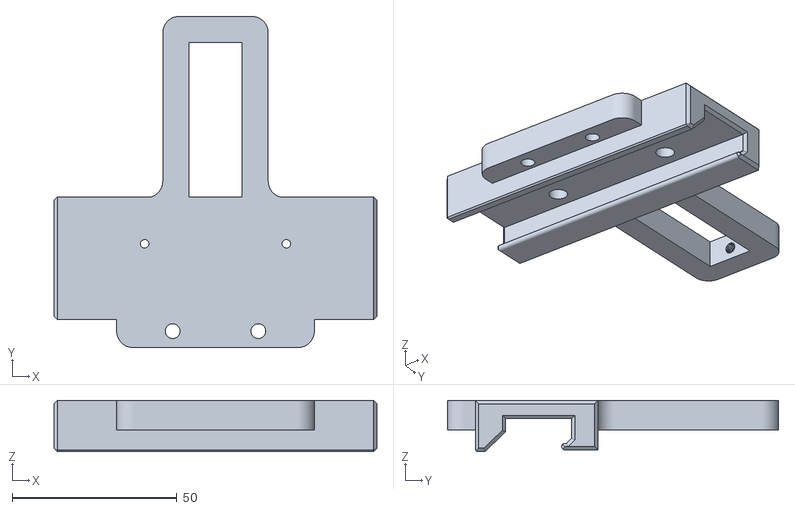
[picture p37: CAD file, 2022-05-19]
3D_Models/Main_Parts/Z/Z-Sync-Pully/STL/Z-Sync-Pully_T-Block.stl
98.0 x 100.5 x 15.5
