DevAnyKR/CreMaker_TuneUp/3D_Models/Main_Parts/Y/Y-bearing-block/STL/Y-bearing-block3.2-C.stl

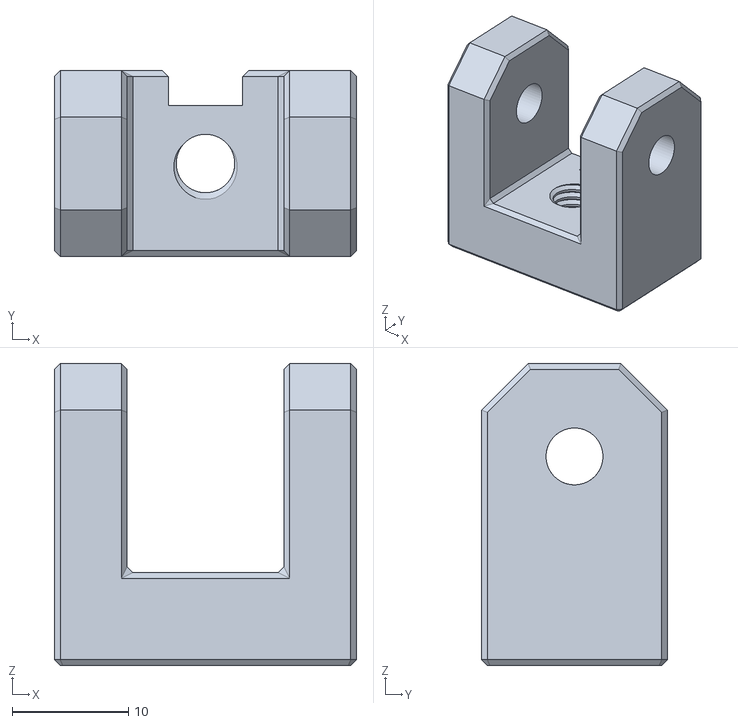
[picture p38: CAD file, 2022-05-19]
3D_Models/Main_Parts/Y/Y-bearing-block/STL/Y-bearing-block3.2-C.stl
26.0 x 16.0 x 26.0
