DevAnyKR/CreMaker_TuneUp/(list of files, cad)

Other CAD files:
3D_Models/Main_Parts/Bed/Bed-belt-block/STP/(2.05)bed-belt-block_B0.stp
3D_Models/Main_Parts/X/Self-Aligning-Module/STL/Magnet_Bottom Plate.stl
3D_Models/Addons/Acrylic_Reinforcement_Block/STL/Acrylic_Reinforcement_Block_180mm_B1.stl
3D_Models/Main_Parts/X/Self-Aligning-Module/stp/X-block-L.stp
3D_Models/Main_Parts/X/Self-Aligning-Module/STL/X-block-R V2.1.stl
3D_Models/Main_Parts/Y/Y-bearing-block/STL/Y-bearing-block3.2-L.stl
3D_Models/Addons/Gyro-Adapter/stl/Z screw cover 7.6x2.0.stl
3D_Models/Main_Parts/Display/Angle_Adjustable_Case/STL/Display_case_front.stl
3D_Models/Main_Parts/Power_Board/Board-Case-Cover_92mm-Fan/stl/Board-Case-Cover_Inner.stl
3D_Models/Main_Parts/X/Self-Aligning-Module/STL/X-Carrige.stl
3D_Models/Main_Parts/Y/Y-bearing-block/STL/Washer M6_1t.stl
3D_Models/Main_Parts/Y/Y-bearing-block/STL/Washer M6_2t.stl
3D_Models/Main_Parts/Y/Y-bearing-block/STL/Washer M6_4t.stl
3D_Models/Main_Parts/Y/Y-bearing-block/STL/Washer M6_8t.stl
3D_Models/Main_Parts/Y/Y-rod-support-Cover/STL/Y-rod-support-Cover_A.stl
3D_Models/Main_Parts/Y/Y-rod-support-Cover/STL/Y-rod-support-Cover_B.stl
3D_Models/Main_Parts/Y/Y-rod-support/STL/Y-rod-support_B1.stl
3D_Models/Main_Parts/Y/Y-rod-support/STL/Y-rod-support_B2.stl
3D_Models/Main_Parts/Z/BearingUnit-Top/STL/Top-cap-L.stl
