DevAnyKR/CreMaker_TuneUp/(commit log)

2022-05-19 아크릴 고정 블록
    [BottomPlateFixBlock100mm_B1.stl, BottomPlateFixBlock180mm_B1.stl, BottomPlateFixBlock180mm_B2.stl, BottomPlateHandle_40mm_B1.stl]
2022-05-19 디스플레이 커버
    [Display_case_bottom.stl, Display_case_cover.stl, Display_case_front.stl]
2022-05-19 BTT 센서 마운트
    [BTTSensorMount_forMaincover V2.0.stl, Body-cover V2.0.stl]
2022-05-19 필라멘트용 베어링
    [Bearing O52_I27_T15.stl, Clip10.stl, Clip4.stl, Clip6.stl]
2022-05-19 92mm팬 파워커버
    [Board-Case-Cover_Inner v7.stl]
2022-05-19 X축 자동조심모듈 세트
    [Magnet_Bottom Plate.stl, Magnet_Top Plate.stl, X-Carrige.stl, X-block-L.stl, X-block-L_V2.1.stl, X-block-R V2.1.stl, X-block-R.stl]
2022-05-19 Y축 모듈
    [Washer M6_1t.stl, Washer M6_2t.stl, Washer M6_4t.stl, Washer M6_8t.stl, Y-bearing-block3.2-C.stl, Y-bearing-block3.2-L.stl, Y-bearing-block3.3-L.stl, Y-rod-support-Cover1.2.stl]
2022-05-19 Z축 튜닝
    [BearingUnit-Bottom-L.stl, Pully Lift.stl, Top-cap-L.stl, Z-Sync-Pully_Guide.stl, Z-Sync-Pully_T-Block.stl, Z-Sync-Pully_Tensioner.stl]
2022-05-19 툴 홀더
    [tool_holder_bottomplate.stl, tool_holder_full_nonplate.stl]
2022-05-19 폴더명 수정
    [BTTSensorMount_forMaincover V2.0.stl, Bearing O52_I27_T15.stl, BearingUnit-Bottom-L.stl, Board-Case-Cover_Inner v7.stl, Body-cover V2.0.stl, BottomPlateFixBlock100mm_B1.stl, BottomPlateFixBlock180mm_B1.stl, BottomPlateFixBlock180mm_B2.stl]
2022-05-19 파일 위치 수정
    [Y-rod-support-Cover1.2.stl, Y-rod-support-Cover2.2.stl]
2022-05-19 파일 구분
    [Magnet_Bottom Plate.stl, Magnet_Top Plate.stl, X-Carrige.stl, X-block-L.stl, X-block-L_V2.1.stl, X-block-R V2.1.stl, X-block-R.stl]
2022-05-19 파일 위치 변경
    [BottomPlateFixBlock100mm_B1.stl, BottomPlateFixBlock180mm_B1.stl, BottomPlateFixBlock180mm_B2.stl, BottomPlateHandle_40mm_B1.stl]
2022-05-19 폴더명 변경
    [Board-Case-Cover_Inner v7.stl]
2022-05-19 파일명 변경
    [Y-rod-support-Cover_A.stl, Y-rod-support-Cover_B.stl]
2022-05-20 파일 경로 변경
    [X-Carrige.stl, X-block-L_V2.1.stl, X-block-R V2.1.stl, X-block-R.stl]
2022-05-20 이미지 등록
2022-05-20 STP 업로드
    [Y-rod-support-Cover_A.stp, Y-rod-support-Cover_B.stp]
2022-05-20 아크릴 강화 블록 위치 변경
    [BottomPlateFixBlock100mm_B1.stl, BottomPlateFixBlock180mm_B1.stl, BottomPlateFixBlock180mm_B2.stl, BottomPlateHandle_40mm_B1.stl]
2022-05-20 이름 변경
    [Display_case_bottom.stl, Display_case_cover.stl, Display_case_front.stl]
2022-05-20 이미지 업로드
2022-05-20 new model
    [Foot Lift Left v1.stl]
2022-05-21 위치 변경
    [BTTSensorMount_forMaincover V2.0.stl, Body-cover V2.0.stl]
2022-05-21 Create BTT Sensor.png
2022-05-21 rename
    step 등록
    [Board-Case-Cover_Inner.step, Board-Case-Cover_Inner.stl]
2022-05-21 step file
    [Y-rod-support_B1.stp, Y-rod-support_B2.stp]
2022-05-25 치수 변경
    구멍 3.2 to 3.5
    너트 내부 구멍 모따기
    [Acrylic_Reinforcement_Block_100mm_B1.stl, Acrylic_Reinforcement_Block_180mm_B1.stl, Acrylic_Reinforcement_Block_180mm_B2.stl]
2022-05-29 stp upload
    [X-Carrige.stp, X-block-L.stp, X-block-R.stp]
2022-06-06 new models
    [Cover10mm.stl, X Motor cover.stl, Z screw cover 7.6x2.0.stl, Z축 정렬 기준점.stl, Z축 정렬 표시기 I8.4.stl]
2022-06-10 폴더 변경
    [X Motor cover.stl, Z screw cover 7.6x2.0.stl]
